fademike/drone/kicad/stm32f103_FlyBoard_si4463/stm32f103_FlyBoard.kicad_pcb

## KiCad design kicad/stm32f103_FlyBoard_si4463/stm32f103_FlyBoard.kicad_pcb (2026-04-30)

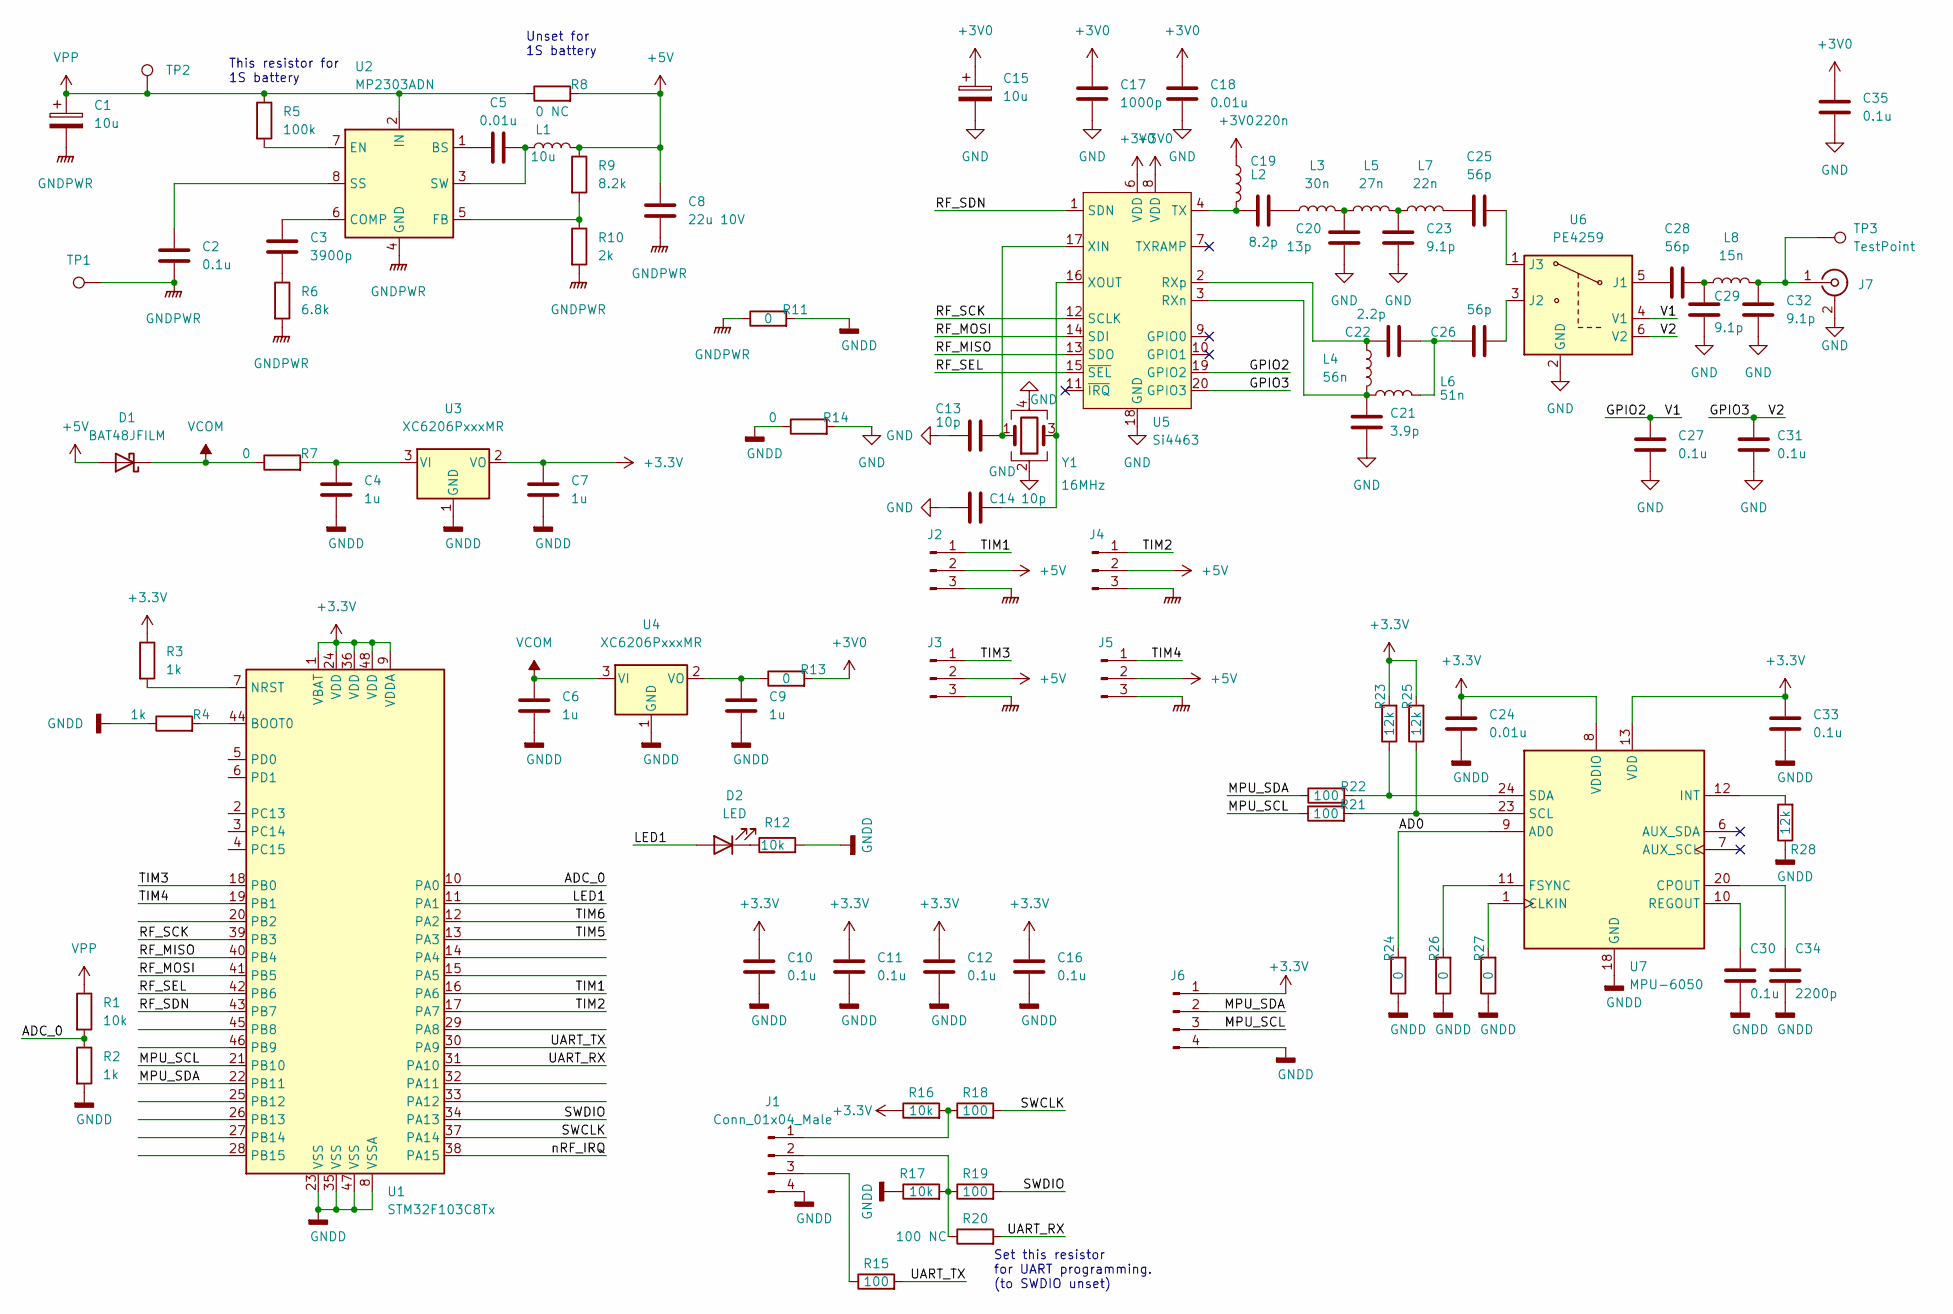
[picture p3: schematic stm32f103_FlyBoard.kicad_sch]

Parts:
C1: 10u; CP_EIA-3528-21_Kemet-B
C2, C10, C11, C12, C16, C27, C30, C31, C33, C35: 0.1u; C_0402_1005Metric
C3: 3900p; C_0402_1005Metric
C4, C6, C7, C9: 1u; C_0402_1005Metric
C5, C18, C24: 0.01u; C_0402_1005Metric
C8: 22u 10V; C_0805_2012Metric
C13, C14: 10p; C_0402_1005Metric
C15: 10u; CP_EIA-3216-18_Kemet-A
C17: 1000p; C_0402_1005Metric
C19: 8.2p; C_0402_1005Metric
C20: 13p; C_0402_1005Metric
C21: 3.9p; C_0402_1005Metric
C22: 2.2p; C_0402_1005Metric
C23, C29, C32: 9.1p; C_0402_1005Metric
C25, C26, C28: 56p; C_0402_1005Metric
C34: 2200p; C_0402_1005Metric
D1: BAT48JFILM; D_SOD-323
D2: LED; LED_0805_2012Metric
J1, J6: Conn_01x04_Male; Molex_PicoBlade_53047-0410_1x04_P1.25mm_Vertical
J2, J3, J4, J5: Conn_01x03_Male; Molex_PicoBlade_53047-0310_1x03_P1.25mm_Vertical
J7: Conn_Coaxial; U.FL_Hirose_U.FL-R-SMT-1_Vertical
L1: 10u; L_Bourns-SRN6028
L2: 220n; L_0402_1005Metric
L3: 30n; L_0402_1005Metric
L4: 56n; L_0402_1005Metric
L5: 27n; L_0402_1005Metric
L6: 51n; L_0402_1005Metric
L7: 22n; L_0402_1005Metric
L8: 15n; L_0402_1005Metric
R1, R12, R17: 10k; R_0402_1005Metric
R2, R3, R4: 1k; R_0402_1005Metric
R5: 100k; R_0402_1005Metric
R6: 6.8k; R_0402_1005Metric
R7, R11, R13, R14: 0; R_0805_2012Metric
R8: 0 NC; R_0805_2012Metric
R9: 8.2k; R_0402_1005Metric
R10: 2k; R_0402_1005Metric
R15, R18, R19, R21, R22: 100; R_0402_1005Metric
R16: 10k; R_0603_1608Metric
R20: 100 NC; R_0402_1005Metric
R23, R25, R28: 12k; R_0402_1005Metric
R24, R26, R27: 0; R_0402_1005Metric
TP1, TP2, TP3: TestPoint; TestPoint_Pad_D1.0mm
U1: STM32F103C8Tx; LQFP-48_7x7mm_P0.5mm
U2: MP2303ADN; SOIC-8-1EP_3.9x4.9mm_P1.27mm_EP2.62x3.51mm
U3, U4: XC6206PxxxMR; SOT-23
U5: Si4463; QFN-20-1EP_4x4mm_P0.5mm_EP2.6x2.6mm
U6: PE4259; SOT-363_SC-70-6
U7: MPU-6050; InvenSense_QFN-24_4x4mm_P0.5mm
Y1: 16MHz; Crystal_SMD_SeikoEpson_FA238-4Pin_3.2x2.5mm

Connections:
+3.3V: C7.1, C10.1, C11.1, C12.1, C16.1, C24.1, C33.1, J6.1, R3.1, R16.1, R23.2, R25.2, U1.1 (VBAT), U1.9 (VDDA), U1.24 (VDD), U1.36 (VDD), U1.48 (VDD), U3.2 (VO), U7.8 (VDDIO), U7.13 (VDD)
+3V0: C15.1, C17.1, C18.1, C35.1, L2.1, R13.2, U5.6 (VDD), U5.8 (VDD)
+5V: C8.1, D1.2 (A), J2.2, J3.2, J4.2, J5.2, L1.2, R8.2, R9.1
/AD0: R24.2, U7.9 (AD0)
/ADC_0: R1.2, R2.1, U1.10 (PA0)
/GPIO2: C27.2, U5.19 (GPIO2), U6.4 (V1)
/GPIO3: C31.2, U5.20 (GPIO3), U6.6 (V2)
/LED1: D2.2 (A), U1.11 (PA1)
/MPU_SCL: J6.3, R21.1, U1.21 (PB10)
/MPU_SDA: J6.2, R22.1, U1.22 (PB11)
/RF_MISO: U1.40 (PB4), U5.13 (SDO)
/RF_MOSI: U1.41 (PB5), U5.14 (SDI)
/RF_SCK: U1.39 (PB3), U5.12 (SCLK)
/RF_SDN: U1.43 (PB7), U5.1 (SDN)
/RF_SEL: U1.42 (PB6), U5.15 (~SEL)
/SWCLK: R18.2, U1.37 (PA14)
/SWDIO: R19.2, U1.34 (PA13)
/TIM1: J2.1, U1.16 (PA6)
/TIM2: J4.1, U1.17 (PA7)
/TIM3: J3.1, U1.18 (PB0)
/TIM4: J5.1, U1.19 (PB1)
/TIM5: U1.13 (PA3)
/TIM6: U1.12 (PA2)
/UART_RX: R20.2, U1.31 (PA10)
/UART_TX: R15.2, U1.30 (PA9)
/nRF_IRQ: U1.38 (PA15)
GND: C13.1, C14.1, C15.2, C17.2, C18.2, C20.1, C21.1, C23.1, C27.1, C29.1, C31.1, C32.1, C35.2, J7.2 (Ext), R14.2, U5.18 (GND), U5.21 (GND), U6.2 (GND), Y1.2, Y1.4
GNDD: C4.2, C6.2, C7.2, C9.2, C10.2, C11.2, C12.2, C16.2, C24.2, C30.2, C33.2, C34.2, J1.4, J6.4, R2.2, R4.1, R11.2, R12.2, R14.1, R17.1, R24.1, R26.1, R27.1, R28.1, U1.8 (VSSA), U1.23 (VSS), U1.35 (VSS), U1.47 (VSS), U3.1 (GND), U4.1 (GND), U7.18 (GND)
GNDPWR: C1.2, C2.2, C8.2, J2.3, J3.3, J4.3, J5.3, R6.2, R10.2, R11.1, TP1.1, U2.4 (GND)
unnamed: C3.2, R6.1
unnamed: C19.2, L3.1
unnamed: C20.2, L3.2, L5.1
unnamed: C22.2, C26.1, L6.2
unnamed: C23.2, L5.2, L7.1
unnamed: C25.2, L7.2
unnamed: C28.1, C29.2, L8.1
unnamed: D2.1 (K), R12.1
unnamed: J1.1, R16.2, R18.1
unnamed: J1.2, R17.2, R19.1, R20.1
unnamed: J1.3, R15.1
unnamed: C32.2, J7.1 (In), L8.2, TP3.1
unnamed: R4.2, U1.44 (BOOT0)
unnamed: R3.2, U1.7 (NRST)
unnamed: C5.1, U2.1 (BS)
unnamed: C3.1, U2.6 (COMP)
unnamed: R5.2, U2.7 (EN)
unnamed: R9.2, R10.1, U2.5 (FB)
unnamed: C2.1, U2.8 (SS)
unnamed: C5.2, L1.1, U2.3 (SW)
unnamed: C4.1, R7.2, U3.3 (VI)
unnamed: C9.1, R13.1, U4.2 (VO)
unnamed: C21.2, L4.2, L6.1, U5.3 (RXn)
unnamed: C22.1, L4.1, U5.2 (RXp)
unnamed: C19.1, L2.2, U5.4 (TX)
unnamed: C13.2, U5.17 (XIN), Y1.1
unnamed: C14.2, U5.16 (XOUT), Y1.3
unnamed: C28.2, U6.5 (J1)
unnamed: C26.2, U6.3 (J2)
unnamed: C25.1, U6.1 (J3)
unnamed: R27.2, U7.1 (CLKIN)
unnamed: C34.1, U7.20 (CPOUT)
unnamed: R26.2, U7.11 (FSYNC)
unnamed: R28.2, U7.12 (INT)
unnamed: C30.1, U7.10 (REGOUT)
unnamed: R21.2, R25.1, U7.23 (SCL)
unnamed: R22.2, R23.1, U7.24 (SDA)
VCOM: C6.1, D1.1 (K), R7.1, U4.3 (VI)
VPP: C1.1, R1.1, R5.1, R8.1, TP2.1, U2.2 (IN)

Notes on the sheet:
Unset for 1S battery
Set this resistor for UART programming. (to SWDIO unset)
This resistor for 1S battery

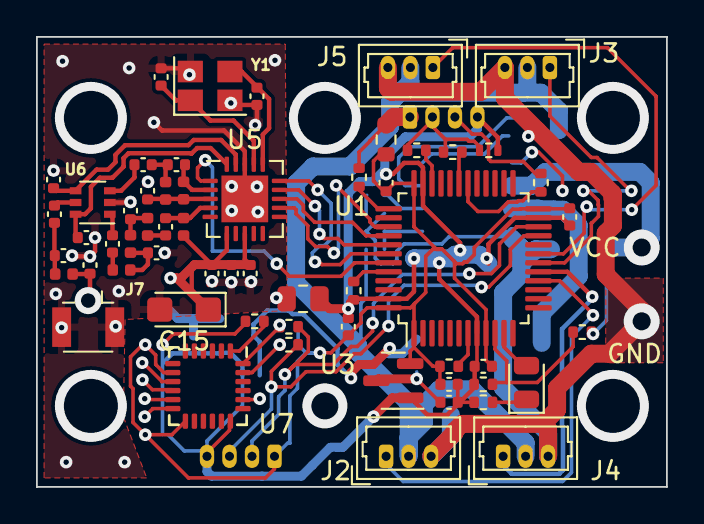
[picture p4: board stm32f103_FlyBoard.kicad_pcb from above]

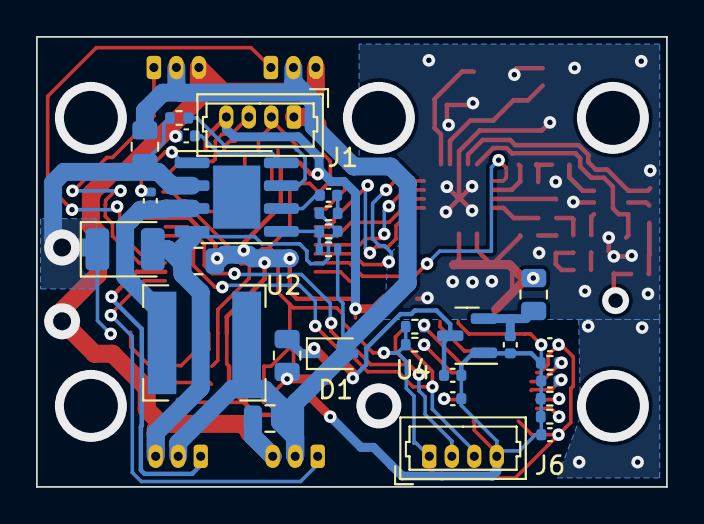
[picture p5: board stm32f103_FlyBoard.kicad_pcb from below]

Board: 2 copper layers, 35.0 x 25.0 mm, 91 parts (30 on the bottom side), 65 nets.
