fademike/drone/kicad/ESC_atmega8/ESC_atmega8.kicad_pcb

## KiCad design kicad/ESC_atmega8/ESC_atmega8.kicad_pcb (2026-04-30)

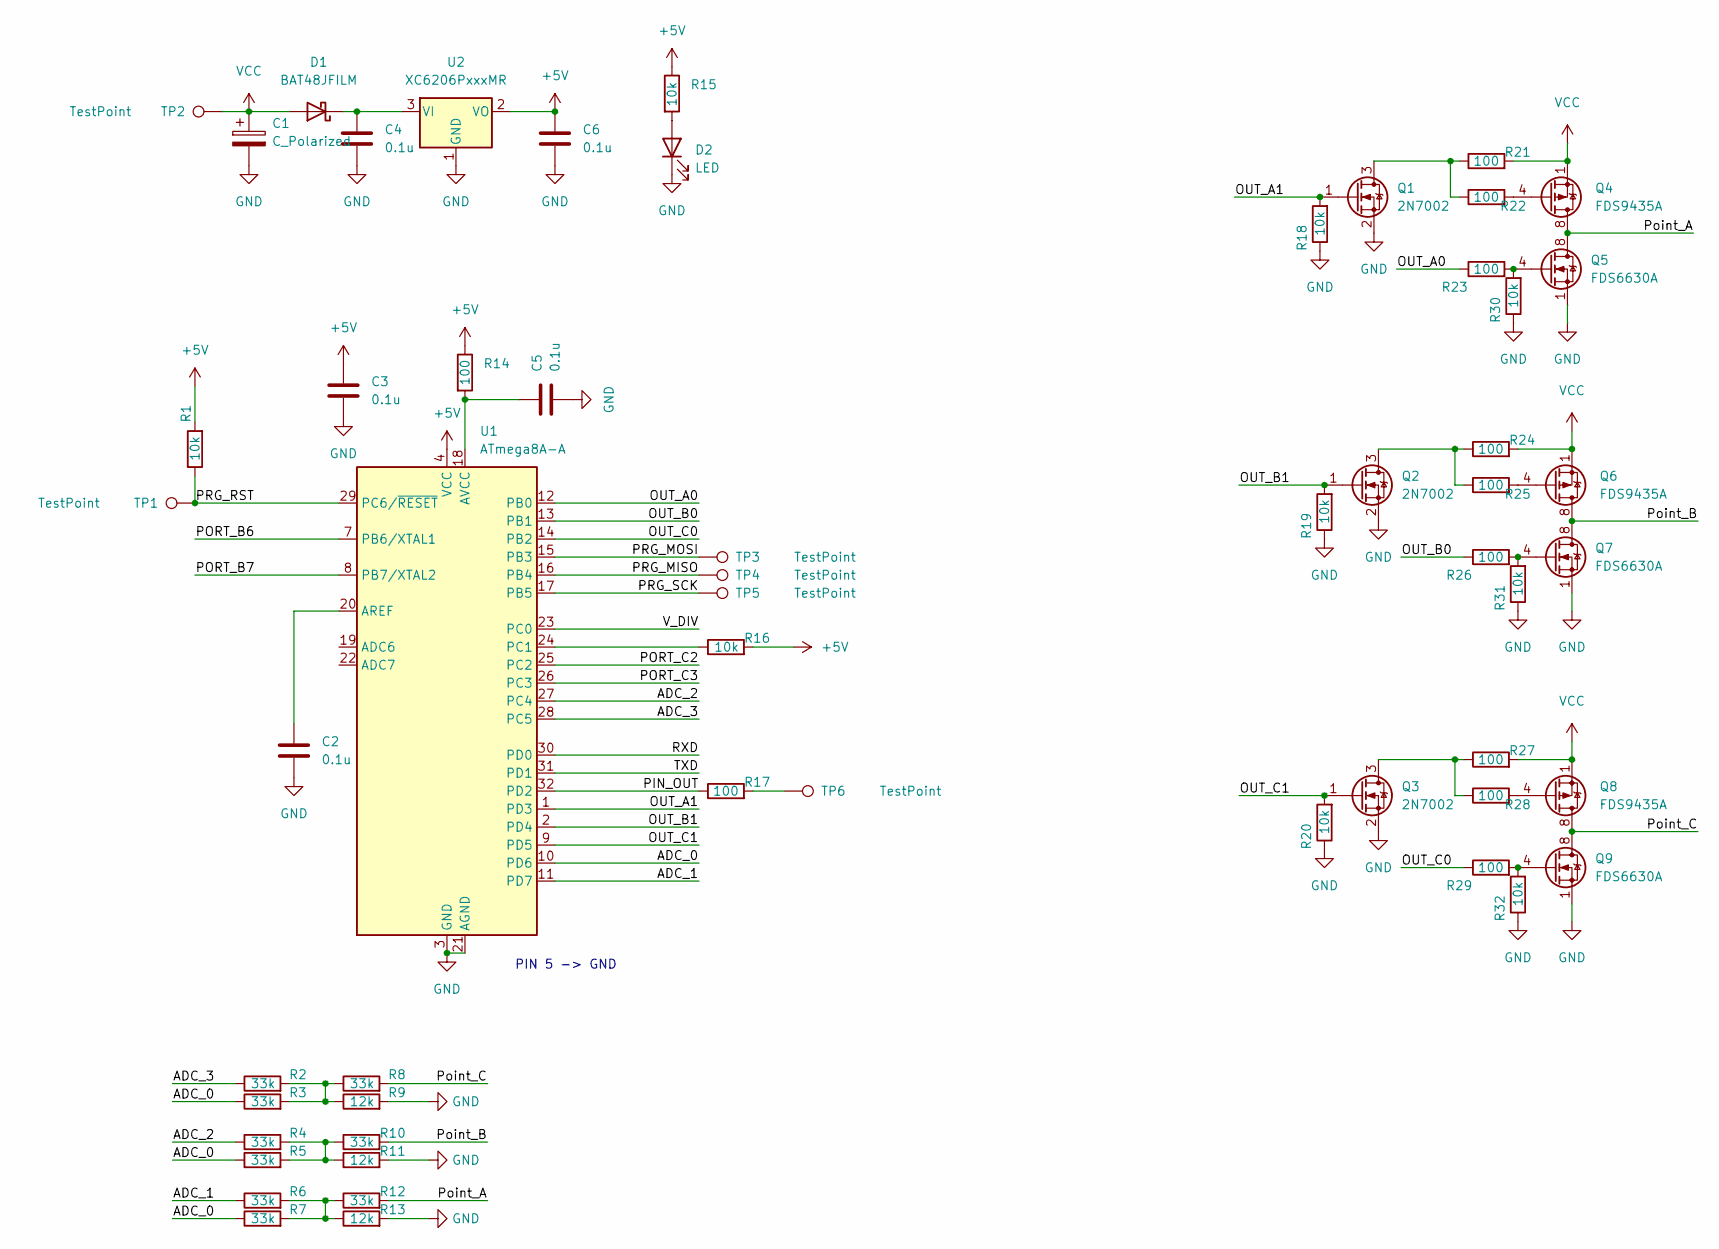
[picture p6: schematic ESC_atmega8.kicad_sch]

Parts:
C1: C_Polarized; CP_EIA-6032-28_Kemet-C
C2, C3, C4, C5, C6: 0.1u; C_0603_1608Metric
D1: BAT48JFILM; D_SOD-323
D2: LED; LED_0805_2012Metric
Q1, Q2, Q3: 2N7002; SOT-23
Q4, Q6, Q8: FDS9435A; SOIC-8_3.9x4.9mm_P1.27mm
Q5, Q7, Q9: FDS6630A; SOIC-8_3.9x4.9mm_P1.27mm
R1, R15, R16, R18, R19, R20, R30, R31, R32: 10k; R_0603_1608Metric
R2, R3, R4, R5, R6, R7, R8, R10, R12: 33k; R_0603_1608Metric
R9, R11, R13: 12k; R_0603_1608Metric
R14, R17, R21, R22, R23, R24, R25, R26, R27, R28, R29: 100; R_0603_1608Metric
TP1, TP2, TP3, TP4, TP5, TP6: TestPoint; TestPoint_Pad_D1.0mm
U1: ATmega8A-A; TQFP-32_7x7mm_P0.8mm
U2: XC6206PxxxMR; SOT-23

Connections:
+5V: C3.1, C6.1, R1.2, R14.1, R15.1, R16.2, U1.4 (VCC), U1.6 (VCC), U2.2 (VO)
/ADC_0: R3.1, R5.1, R7.1, U1.10 (PD6)
/ADC_1: R6.1, U1.11 (PD7)
/ADC_2: R4.1, U1.27 (PC4)
/ADC_3: R2.1, U1.28 (PC5)
/OUT_A0: R23.1, U1.12 (PB0)
/OUT_A1: Q1.1 (G), R18.2, U1.1 (PD3)
/OUT_B0: R26.1, U1.13 (PB1)
/OUT_B1: Q2.1 (G), R19.2, U1.2 (PD4)
/OUT_C0: R29.1, U1.14 (PB2)
/OUT_C1: Q3.1 (G), R20.2, U1.9 (PD5)
/PIN_OUT: R17.1, U1.32 (PD2)
/PORT_B6: U1.7 (PB6/XTAL1)
/PORT_B7: U1.8 (PB7/XTAL2)
/PORT_C2: U1.25 (PC2)
/PORT_C3: U1.26 (PC3)
/PRG_MISO: TP4.1, U1.16 (PB4)
/PRG_MOSI: TP3.1, U1.15 (PB3)
/PRG_RST: R1.1, TP1.1, U1.29 (PC6/~RESET)
/PRG_SCK: TP5.1, U1.17 (PB5)
/Point_A: Q4.5 (D), Q4.6 (D), Q4.7 (D), Q4.8 (D), Q5.5 (D), Q5.6 (D), Q5.7 (D), Q5.8 (D), R12.2
/Point_B: Q6.5 (D), Q6.6 (D), Q6.7 (D), Q6.8 (D), Q7.5 (D), Q7.6 (D), Q7.7 (D), Q7.8 (D), R10.2
/Point_C: Q8.5 (D), Q8.6 (D), Q8.7 (D), Q8.8 (D), Q9.5 (D), Q9.6 (D), Q9.7 (D), Q9.8 (D), R8.2
/RXD: U1.30 (PD0)
/TXD: U1.31 (PD1)
/V_DIV: U1.23 (PC0)
GND: C1.2, C2.2, C3.2, C4.2, C5.2, C6.2, D2.1 (K), Q1.2 (S), Q2.2 (S), Q3.2 (S), Q5.1 (S), Q5.2 (S), Q5.3 (S), Q7.1 (S), Q7.2 (S), Q7.3 (S), Q9.1 (S), Q9.2 (S), Q9.3 (S), R9.2, R11.2, R13.2, R18.1, R19.1, R20.1, R30.1, R31.1, R32.1, U1.3 (GND), U1.5 (GND), U1.21 (AGND), U2.1 (GND)
unnamed: C2.1, U1.20 (AREF)
unnamed: C4.1, D1.1 (K), U2.3 (VI)
unnamed: C5.1, R14.2, U1.18 (AVCC)
unnamed: D2.2 (A), R15.2
unnamed: Q1.3 (D), R21.1, R22.1
unnamed: Q2.3 (D), R24.1, R25.1
unnamed: Q3.3 (D), R27.1, R28.1
unnamed: Q4.4 (G), R22.2
unnamed: Q5.4 (G), R23.2, R30.2
unnamed: Q6.4 (G), R25.2
unnamed: Q7.4 (G), R26.2, R31.2
unnamed: Q8.4 (G), R28.2
unnamed: Q9.4 (G), R29.2, R32.2
unnamed: R2.2, R3.2, R8.1, R9.1
unnamed: R4.2, R5.2, R10.1, R11.1
unnamed: R6.2, R7.2, R12.1, R13.1
unnamed: R16.1, U1.24 (PC1)
unnamed: R17.2, TP6.1
VCC: C1.1, D1.2 (A), Q4.1 (S), Q4.2 (S), Q4.3 (S), Q6.1 (S), Q6.2 (S), Q6.3 (S), Q8.1 (S), Q8.2 (S), Q8.3 (S), R21.2, R24.2, R27.2, TP2.1

Notes on the sheet:
PIN 5 -> GND

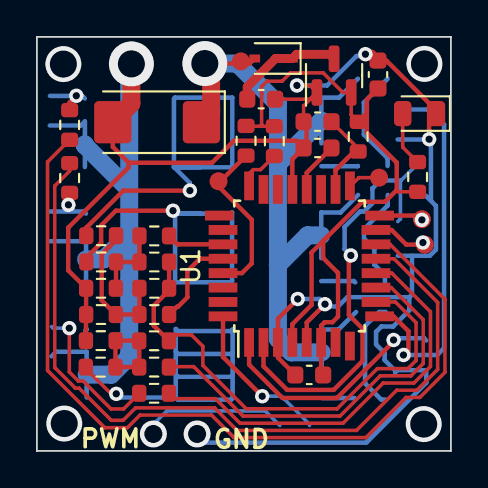
[picture p7: board ESC_atmega8.kicad_pcb from above]

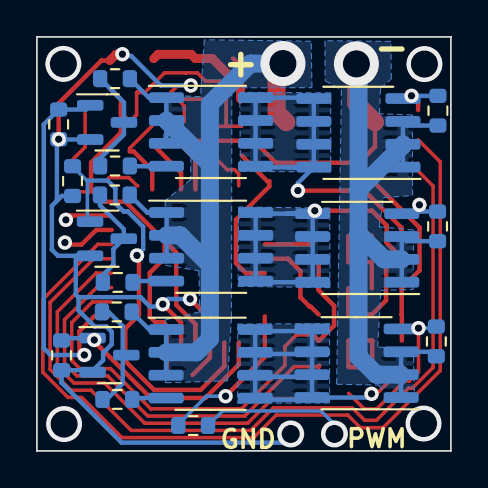
[picture p8: board ESC_atmega8.kicad_pcb from below]

Board: 2 copper layers, 23.0 x 23.0 mm, 57 parts (23 on the bottom side), 39 nets.
