fademike/drone/kicad/tiny_2nmosfet/tiny_2nmosfet.kicad_pcb

## KiCad design kicad/tiny_2nmosfet/tiny_2nmosfet.kicad_pcb (2026-04-30)

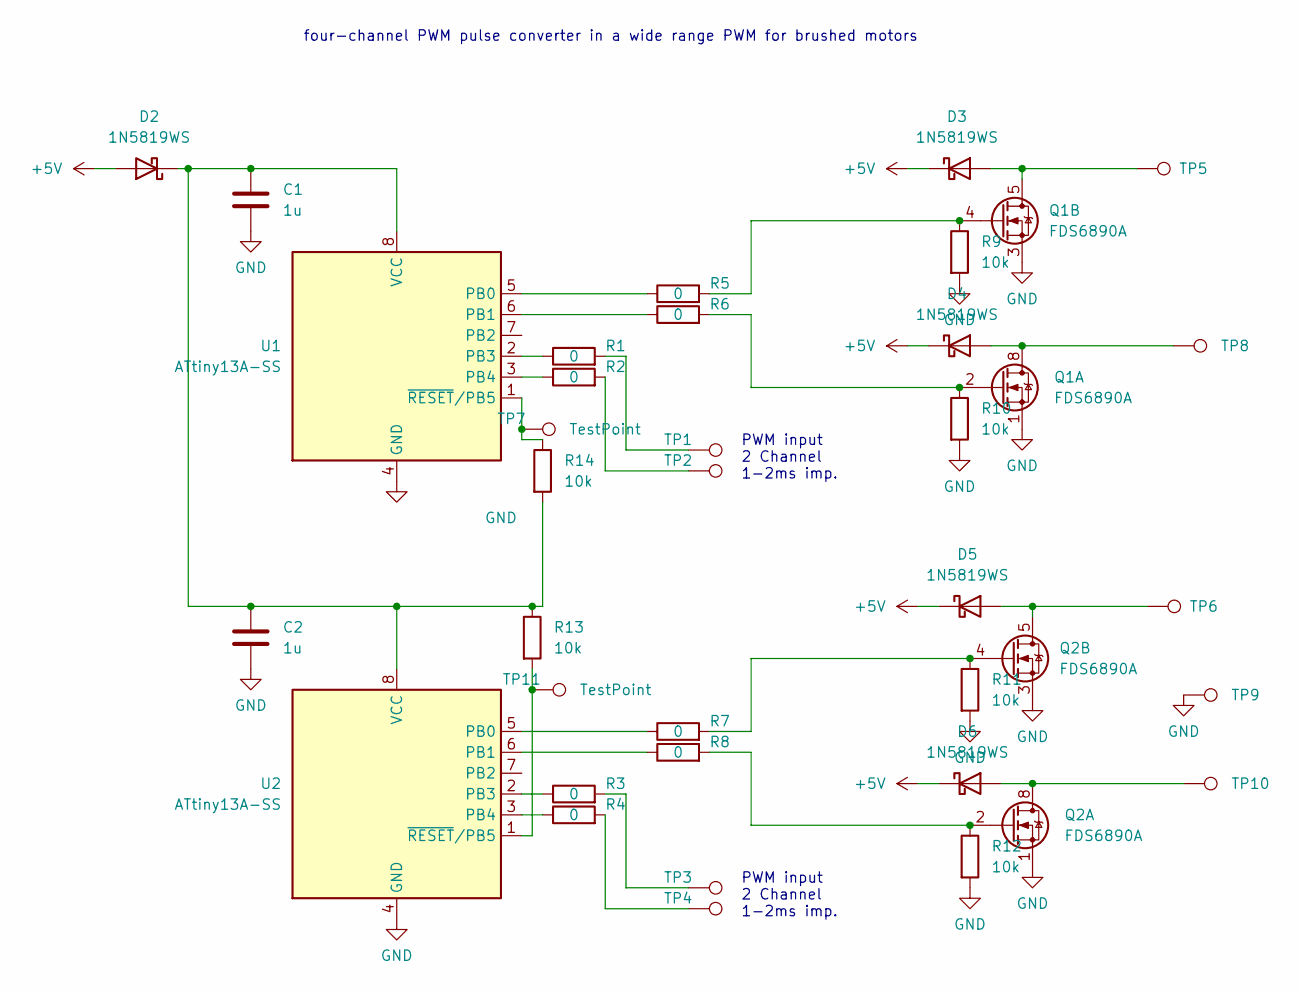
[picture p9: schematic tiny_2nmosfet.kicad_sch]

Parts:
C1, C2: 1u; C_0603_1608Metric
D2, D3, D4, D5, D6: 1N5819WS; D_SOD-323
Q1, Q2: FDS6890A; SOIC-8_3.9x4.9mm_P1.27mm
R1, R2, R3, R4, R5, R6, R7, R8: 0; R_0603_1608Metric
R9, R10, R11, R12, R13, R14: 10k; R_0603_1608Metric
TP1, TP2, TP3, TP4, TP5, TP6, TP7, TP8, TP9, TP10, TP11: TestPoint; PinHeader_1x01_P2.54mm_Vertical
U1, U2: ATtiny13A-SS; SOIC-8_3.9x4.9mm_P1.27mm

Connections:
+5V: D2.2 (A), D3.1 (K), D4.1 (K), D5.1 (K), D6.1 (K)
GND: C1.2, C2.2, Q1.1 (S1), Q1.3 (S2), Q2.1 (S1), Q2.3 (S2), R9.2, R10.2, R11.2, R12.2, TP9.1, U1.4 (GND), U2.4 (GND)
unnamed: C1.1, C2.1, D2.1 (K), R13.1, R14.2, U1.8 (VCC), U2.8 (VCC)
unnamed: D3.2 (A), Q1.5 (D2), Q1.6 (D2), TP5.1
unnamed: D4.2 (A), Q1.7 (D1), Q1.8 (D1), TP8.1
unnamed: D5.2 (A), Q2.5 (D2), Q2.6 (D2), TP6.1
unnamed: D6.2 (A), Q2.7 (D1), Q2.8 (D1), TP10.1
unnamed: Q1.2 (G1), R6.2, R10.1
unnamed: Q1.4 (G2), R5.2, R9.1
unnamed: Q2.2 (G1), R8.2, R12.1
unnamed: Q2.4 (G2), R7.2, R11.1
unnamed: R1.2, TP1.1
unnamed: R2.2, TP2.1
unnamed: R3.2, TP3.1
unnamed: R4.2, TP4.1
unnamed: R5.1, U1.5 (PB0)
unnamed: R6.1, U1.6 (PB1)
unnamed: R1.1, U1.2 (PB3)
unnamed: R2.1, U1.3 (PB4)
unnamed: R14.1, TP7.1, U1.1 (~RESET/PB5)
unnamed: R7.1, U2.5 (PB0)
unnamed: R8.1, U2.6 (PB1)
unnamed: R3.1, U2.2 (PB3)
unnamed: R4.1, U2.3 (PB4)
unnamed: R13.2, TP11.1, U2.1 (~RESET/PB5)

Notes on the sheet:
PWM input 2 Channel 1-2ms imp.
four-channel PWM pulse converter in a wide range PWM for brushed motors

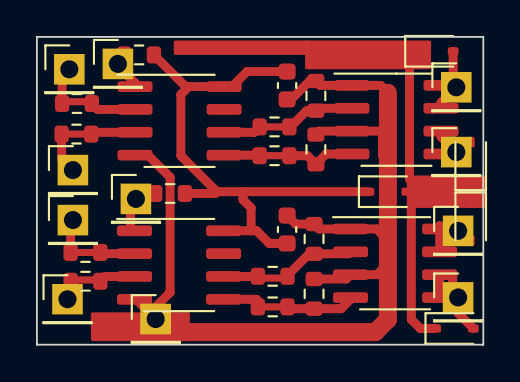
[picture p10: board tiny_2nmosfet.kicad_pcb from above]

Board: 2 copper layers, 24.8 x 17.1 mm, 36 parts (0 on the bottom side), 25 nets.
