fademike/drone/Core/Src/main.c

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
/* Includes ------------------------------------------------------------------*/
#include "main.h"

/* USER CODE BEGIN Includes */

#include <string.h>		// for strlen
#include <stdio.h>		// for sprintf
#include <math.h>		  // for abs and other

#include "radio_config_Si4463.h"

// #include "debug.h"

#include "params.h"
#include "system.h"
#include "mavlink_handler.h"

#include "imu.h"
#include "cb.h"

#include "ModemControl.h"
#include "MotorControl.h"
/* USER CODE END Includes */

ADC_HandleTypeDef hadc1;

I2C_HandleTypeDef hi2c2;

IWDG_HandleTypeDef hiwdg;

SPI_HandleTypeDef hspi1;

TIM_HandleTypeDef htim1;
TIM_HandleTypeDef htim2;
TIM_HandleTypeDef htim3;

UART_HandleTypeDef huart1;
UART_HandleTypeDef huart2;
DMA_HandleTypeDef hdma_usart2_tx;

/* USER CODE BEGIN PV */

// __attribute__((section(".isr_vector"), used))
// const uint32_t vector_table[] = {
//   // (uint32_t)&_estack,
//   (uint32_t)*(uint32_t *)&Reset_Handler,
//   (uint32_t)*(uint32_t *)&NMI_Handler
// };

/* USER CODE END PV */

void SystemClock_Config(void);
static void MX_GPIO_Init(void);
static void MX_DMA_Init(void);
static void MX_ADC1_Init(void);
static void MX_I2C2_Init(void);
static void MX_IWDG_Init(void);
static void MX_SPI1_Init(void);
static void MX_TIM1_Init(void);
static void MX_TIM2_Init(void);
static void MX_TIM3_Init(void);
static void MX_USART1_UART_Init(void);
static void MX_USART2_UART_Init(void);
/* USER CODE BEGIN 0 */

void test_set(int set){
  if (set !=0) HAL_GPIO_WritePin(PIN_TEST_GPIO_Port, PIN_TEST_Pin, GPIO_PIN_SET);
  else HAL_GPIO_WritePin(PIN_TEST_GPIO_Port, PIN_TEST_Pin, GPIO_PIN_RESET);

}

volatile uint32_t tick_ms = 0;

char rx_uart_it;  // buffer for irq uart data

uint32_t Get_tick(void){
  return tick_ms;
}

// void HAL_IncTick(void)
// {
//   uwTick += uwTickFreq;
// }

void SYS_myTick(void)  // IRQ 1 ms
{
  tick_ms++;
  //reset timer for calculate us
  if (htim1.Instance != 0)__HAL_TIM_SET_COUNTER(&htim1, 0); // reset for timer counter us
}

//void Printf(const char *fmt, ...){
//  HAL_UART_Transmit(&huart1, (unsigned char *)fmt, strlen(fmt), 500);
//}
#include <stdarg.h>
void Printf(const char *fmt, ...)
{
  char buf[256];
  va_list lst;
  va_start(lst, fmt);
  vsprintf(buf, fmt, lst);
  va_end(lst);
  HAL_UART_Transmit(&huart1, (unsigned char *)buf, strlen(buf), 500);
  if (ModemControl_getStatus()>=0) mavlink_send_statustext(buf);
}

// for printf. the size is larger on 2k
// int _write(int fd, char* ptr, int len) {
//     HAL_UART_Transmit(&huart1, (uint8_t *) ptr, len, HAL_MAX_DELAY);
//   ptr[len] = '\0';
//   if (ModemControl_getStatus()>=0) mavlink_send_statustext(ptr);
//     return len;
// }

void HAL_UART_RxCpltCallback(UART_HandleTypeDef *huart) {
  // Your code to handle received data

  if (huart != &huart2) return;
  // only for uart2:

  mavlink_receive(rx_uart_it);
  HAL_UART_Receive_IT(huart, &rx_uart_it, 1);  // Enable USART receive interrupt again
}


/* USER CODE END 0 */

/**
  * @brief  The application entry point.
  * @retval int
  */
int main(void)
{

  /* MCU Configuration--------------------------------------------------------*/

  /* Reset of all peripherals, Initializes the Flash interface and the Systick. */
  HAL_Init();

  /* Configure the system clock */
  SystemClock_Config();

  /* Initialize all configured peripherals */
  MX_GPIO_Init();
  MX_DMA_Init();
  MX_ADC1_Init();
  MX_I2C2_Init();
  MX_IWDG_Init();
  MX_SPI1_Init();
  MX_TIM1_Init();
  MX_TIM2_Init();
  MX_TIM3_Init();
  MX_USART1_UART_Init();
  MX_USART2_UART_Init();
  /* USER CODE BEGIN 2 */

  Printf("...\n\r");

  __enable_irq();
  HAL_IWDG_Init(&hiwdg);
  __HAL_IWDG_START(&hiwdg);
  HAL_IWDG_Refresh(&hiwdg);

  HAL_UART_Receive_IT(&huart2, &rx_uart_it, 1); 

  HAL_TIM_Base_Start(&htim1); // timer for us calculate
  HAL_TIM_Base_Start(&htim2); // reserv for additional motors
  HAL_TIM_Base_Start(&htim3); // timer for motor pwm

  // HAL_TIM_PWM_Start(&htim2, TIM_CHANNEL_2); // for additional motors
  // HAL_TIM_PWM_Start(&htim2, TIM_CHANNEL_4); // for additional motors

  HAL_TIM_PWM_Start(&htim3, TIM_CHANNEL_1); // motor 1
  HAL_TIM_PWM_Start(&htim3, TIM_CHANNEL_2); // motor 2
  HAL_TIM_PWM_Start(&htim3, TIM_CHANNEL_3); // motor 3
  HAL_TIM_PWM_Start(&htim3, TIM_CHANNEL_4); // motor 4

  params_restore();

  HAL_IWDG_Refresh(&hiwdg);

  MotorControl_init();

  if (imu_init() < 0) if (IMU_MUST_BE) system_reboot();
  if (ModemControl_init() < 0) {
    Printf("MC_init false\n\r"); 
    system_changeThread(THREAD_MODEMCONTROL, THREAD_ENABLE, 0); // disable THREAD_MODEMCONTROL
    if (MC_MUST_BE) system_reboot();
  };

  Printf("Started...\n\r");

  /* USER CODE END 2 */

  /* Infinite loop */
  /* USER CODE BEGIN WHILE */
  while (1)
  {
    HAL_IWDG_Refresh(&hiwdg);

    int thread = Thread_Cycle();

    switch (thread){
        case(THREAD_IMU_LOOP):
          mavlink_loop(); // if no mc
          imu_loop();
          break;
        case(THREAD_TEST):
          // static int ii=0;
          // Printf("test %d\n\r", ii++);
          HAL_GPIO_TogglePin(PIN_TEST_GPIO_Port, PIN_TEST_Pin);
          HAL_GPIO_TogglePin(PIN_TEST2_GPIO_Port, PIN_TEST2_Pin);
          if (MotorControl_isArmed()) system_changeThread(THREAD_TEST, THREAD_T_INTERVAL, 100);
          else system_changeThread(THREAD_TEST, THREAD_T_INTERVAL, 500);  //500

          if (ModemControl_getStatus() < 0){ // for timeout. if no rx uart data on start and mc fail => reboot;
            static int t=0;
            if (mavlink_currNRxPack() == 0) t++;
            else t=0;
            if (t >= 10) system_reboot();
          }
          // int alt_max = (int)params_GetParamValue(ALT_MAX);
          // if ((alt_max > 0) && (!MotorControl_isArmed())){
          //   int dist = imu_getAlt();
          //   Printf("dist = %d\n\r", dist);
          // }
          break;
        case(THREAD_MODEMCONTROL):
          mavlink_loop();
          if (ModemControl_getStatus()>=0){
            ModemControl_Loop();
          }
            //if (ModemControl_Loop() == 1){  // if rx data pack
              uint8_t buff_pack[64];
              int32_t rx_len = ModemControl_GetPacket(buff_pack); // if exist pack
              if (rx_len > 0) mavlink_receive_pack(buff_pack, rx_len);  // send packet to parse
            //}
          break;
        case(THREAD_MAV_SEND_ATTITUDE):
          mavlink_send_attitude();
          break;
        case(THREAD_MAV_SEND_STATUS):
          mavlink_send_heartbeat();
          mavlink_send_status();
          break;
        case(THREAD_ADC):
          Battery_Read();
          break;
    }

    /* USER CODE END WHILE */

    /* USER CODE BEGIN 3 */
  }
  /* USER CODE END 3 */
}

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
