fademike/drone/Core/Inc/main.h

#define PIN_TEST2_Pin GPIO_PIN_13
#define PIN_TEST2_GPIO_Port GPIOC
#define PIN_TEST_Pin GPIO_PIN_1
#define PIN_TEST_GPIO_Port GPIOA
#define SPI1_NSS_Pin GPIO_PIN_6
#define SPI1_NSS_GPIO_Port GPIOB
#define SI_SDN_Pin GPIO_PIN_7
#define SI_SDN_GPIO_Port GPIOB
#define MPU6050 0
#define MPU9250 1
#define MPU_CHIP MPU6050	//FIX HERE!!!
#define IMU_MUST_BE 1  // No work without IMU sensor
#define MC_MUST_BE 0 // 0 - may be worked via uart. 1 - only RF spi
#define msleep HAL_Delay
#define GetTime_ms Get_tick//system_getTime_ms
#define STM32   //LINUX // STM32
