fademike/drone/tests/host/imu_data_generate.c

// Используя Unity Test Framework для embedded
#include <stdlib.h>
#include <math.h>
#include "imu_data_generate.h"

//static vec3_t acc = {0,0,1};
static vec3_t angles = {0,0,0};
static vec3_t speed_rate = {0,0,0};
static float angle_change_speed = 0;
static vec3_t gyro = {0,0,0};
static float noise_level = 0.1;
/*
void gen_set_acc(vec3_t a){
    acc = a;
}

void gen_set_gyro(vec3_t g){
    gyro = g;
}
*/
void gen_set_noise_lvl(float n){
    noise_level = n;
}

void change_pos(vec3_t angle, vec3_t speed){
    // angles = angle;
    speed_rate = speed;
}

float very_fast_sin(float x) {
    // sin(x) ≈ x (для малых углов)
    while (x > 3.14159f) x -= 6.28318f;
    while (x < -3.14159f) x += 6.28318f;
    
    return x - (x * x * x) / 6.0f;
}

float very_fast_cos(float x) {
  return very_fast_sin(x + 1.570796f);
}

   // Заглушка для sincosf, которая эмулирует её поведение
 void sincosf(float x, float *psin, float *pcos) {
       *psin = very_fast_sin(x);//sinf(x);
       *pcos = very_fast_cos(x);//cosf(x);
   }


static vec3_t gen_noise(float noise_level){
  return (vec3_t){(((float)rand() / (float)RAND_MAX) -0.5f )*noise_level,
        (((float)rand() / (float)RAND_MAX) -0.5f )*noise_level,
        (((float)rand() / (float)RAND_MAX) -0.5f )*noise_level};
}
/*
vec3_t gen_acc(float dt){

    angles = vec3_add(angles, vec3_mul_const(speed_rate, dt));

    gyro = speed_rate;

    float roll = angles.x*3.14f/180.0f;
    float pitch = angles.y*3.14f/180.0f;

    acc.x = -sinf(pitch);
    acc.y = sinf(roll)*cosf(pitch);
    acc.z = cosf(roll)*cosf(pitch);

    vec3_t noise = gen_noise(noise_level);
    
    return vec3_add(acc, noise);
}


vec3_t gen_gyro(void){

    vec3_t noise = gen_noise(noise_level);
    return vec3_add(gyro, noise);
}
*/
void gen_set_angle(vec3_t a){
    angles = a;
}

void gen_imu(vec3_t * acc, vec3_t * gyro, vec3_t speed, float dt){
    angles = vec3_add(angles, vec3_mul_const(speed, dt));

    float roll = angles.x*3.14f/180.0f;
    float pitch = angles.y*3.14f/180.0f;

    vec3_t a;
    a.x = -sinf(pitch);
    a.y = sinf(roll)*cosf(pitch);
    a.z = cosf(roll)*cosf(pitch);
    
    //vec3_t g = *gyro;
    *acc = vec3_add(a, gen_noise(noise_level));
    *gyro = speed;//vec3_add(speed_rate, gen_noise(noise_level));
    //*gyro = (vec3_t){1,1,1};
}
