fademike/drone/(commit log)

2026-04-30 lets go..
    [ESC_atmega8.kicad_pcb, ESC_atmega8.kicad_sch, stm32f103_FlyBoard.kicad_pcb, stm32f103_FlyBoard.kicad_sch, tiny_2nmosfet.kicad_pcb, tiny_2nmosfet.kicad_sch]
2026-05-02 gyro test finish
2026-05-09 host with network mavlink. imu data gen started
2026-05-11 generator imu worked!
2026-05-13 upgrated gen and fix to mahony for android host
    [MahonyAHRS.c, imu_data_generate.c, imu_data_generate.h, imu_rearrange.c, network.c]
2026-05-15 changed untill new rr calibrate and test
